humatej/Alb_msg_project2022/README.md

# Albert Message final school project #

Author: Matej Hušla 2022

This is iot project about monitoring Bee hive. Concretely we are monitoring humidity and air temperature but also aligment.
Nodes are connecting throught mesh network. All data is sent by GSM module to database.

All library I use:
 - PainlessMesh: https://github.com/gmag11/painlessMesh
 - DHT senzor library: https://github.com/adafruit/DHT-sensor-library
 - Adafruit_MPU6050: https://github.com/adafruit/Adafruit_MPU6050
 - EspSoftwareSerial: https://github.com/plerup/espsoftwareserial

Actual version: 0.9.8
