humatej/Alb_msg_project2022/(commit log)

2022-03-29 fixing security code leak
    [regularModul.ino]
2022-04-22 fixing upload issues, version with debbuging tools
    [centralModul.ino, regularModul.ino]
2022-04-27 fixing some issues with sending of data
    [centralModul.ino, regularModul.ino]
